ibanman555/Kurzweil-PC2-keyboardscanner/README.md

Kurzweil PC2

# Kurzweil PC2 76-Key MIDI Controller

This repository is for a **Kurzweil PC2 76-key keybed converted into a standalone MIDI controller using one Arduino Mega 2560 and a custom shield**.

The hardware and firmware are specifically for the PC2 keybed, its original pitch/mod wheel assembly, the two illuminated switches directly above the wheels (SW4 = Octave Down, SW5 = Octave Up), and a 1/4-inch sustain-pedal input.

## Current verified status

The assembled single-Mega PC2 has physically verified:

- all 76 keys on the Bass and Treble ribbons, including variable MIDI velocity
- pitch wheel
- mod wheel
- octave down / normal / octave up
- the two original button LEDs following the correct octave state
- the disconnected-J11 startup protection for the pitch/mod analog inputs
- the sustain firmware/input path

PC2 PRESSR/aftertouch is routed to A3 for future use, but aftertouch MIDI output is intentionally not enabled yet.

## Downloading and opening the Arduino sketch

GitHub's downloaded ZIP adds a suffix to the repository folder name, so the firmware is intentionally kept in its own valid Arduino sketch folder:

```text
keyboardscanner/
    keyboardscanner.ino
    globals.h
    scanner.cpp
    states.cpp
    midi.cpp
    potentiometers.cpp
    velocity.h
    extensions.h
    models/kurzweil_pc2/...
```

After downloading and extracting the ZIP, open:

```text
keyboardscanner/keyboardscanner.ino
```

**Keep the entire `keyboardscanner` folder together. Do not move only the `.ino` file.**

In Arduino IDE select **Arduino Mega or Mega 2560**, install the **DIO2** library, then compile and upload.

## Legacy dual-Mega prototype MIDI connection

This project's prototype used 2 separate Arduino Mega 2560s to allow both PC2 keybed ribbon connectors to be attached to the digital pins without modification. The successful dual-Mega prototype used the Mega's normal USB serial connection as a COM port and Bome as the serial-to-MIDI bridge:

- Serial speed: **31250 baud**
- Format: **8N1**
- Arduino Serial Monitor: **closed**
- Bome: configure the Mega COM port as a serial MIDI input

The stock Mega 2560 USB connection is a serial/COM device, not a native USB-MIDI device. The firmware sends standard MIDI bytes through `Serial` at 31250 baud, exactly as used in the prototype.

### Optional native USB-MIDI with HIDUINO

After the PC2 sketch has been compiled and uploaded to the Mega 2560, the board can alternatively be configured as a **class-compliant USB-MIDI device** using [HIDUINO](https://github.com/ddiakopoulos/hiduino).

HIDUINO does not replace the PC2 sketch on the main ATmega2560. Instead, it replaces the normal `usbserial` firmware on the Mega's separate USB-interface AVR. HIDUINO officially supports the Mega 2560 when that USB-interface chip is an **ATmega16U2** (Mega 2560 R3) or **ATmega8U2** (older revisions). It does **not** work on Mega-compatible boards that use a fixed USB-to-serial chip such as CH340, FTDI, or CP2102.

The current PC2 sketch is already compatible with HIDUINO as written. `keyboardscanner.ino` starts UART0 with `Serial.begin(31250)`, and HIDUINO's `arduino_midi` firmware also initializes its serial side at **31250 baud**. The PC2 firmware's normal MIDI path sends the MIDI status and data bytes with `Serial.write()`; HIDUINO receives those raw MIDI bytes and presents them to the computer as a class-compliant USB-MIDI device. No Bome serial-to-MIDI bridge is required once HIDUINO is installed.

The source file `keyboardscanner/midi.cpp` does contain `Serial.print()` / `Serial.println()` statements for diagnostics, but they are inside the compile-time-only `DEBUG_VELOCITY_TIMES` and `DEBUG_MIDI_MESSAGE` sections. Those debug options are **not enabled in the current PC2 build**, so the debug text is not compiled into the running firmware and is safe to leave in the source when HIDUINO is used. **Do not enable either debug option while HIDUINO is active**, because ASCII debug text would then be inserted into the same serial byte stream HIDUINO interprets as MIDI.

#### Included ATmega16U2 firmware and recommended programmer

For Mega 2560 boards that use an **ATmega16U2** as the USB interface, this repository now includes the exact USB-interface firmware used for this PC2 project:

- **[ATmega_16u2_PC2.hex](firmware/atmega16u2/ATmega_16u2_PC2.hex)** — custom HIDUINO build with the USB product name changed to **Kurzweil PC2**. With the PC2 sketch running on the main ATmega2560, the board appears to the computer as a class-compliant USB-MIDI device named **Kurzweil PC2**.
- **[usbserial_mega_16u2.hex](firmware/atmega16u2/usbserial_mega_16u2.hex)** — restore firmware for returning the Mega 2560 ATmega16U2 to its normal USB serial/COM-port behavior.
- **[ATmega16U2 flashing guide](firmware/atmega16u2/README.md)** — programming target, connection, recovery, and ISP instructions.

These two HEX files are specifically for the **ATmega16U2 USB-interface MCU**, not the main ATmega2560 that runs the PC2 sketch. Do not flash them to the main ATmega2560, and do not use these 16U2 images on an 8U2 or on Mega-compatible boards with CH340, FTDI, CP2102, or similar USB chips.

For easy installation and recovery, this project recommends the **Olimex AVR-ISP-MK2**, available from Mouser as **Mouser # 909-AVR-ISP-MK2**: https://www.mouser.com/ProductDetail/Olimex-Ltd/AVR-ISP-MK2

When programming these files, connect the AVR-ISP-MK2 to the **ATmega16U2's 2x3 ICSP header near the Mega's USB connector**, not the separate ICSP header for the main ATmega2560.

**Important development limitation:** once HIDUINO is loaded on the 8U2/16U2, the Mega no longer provides its normal USB serial/COM interface, so the Arduino IDE cannot upload changes to the PC2 sketch through the normal USB cable. To edit and re-upload the PC2 sketch, either temporarily restore the Mega's `usbserial` firmware, upload the revised sketch, and then re-flash HIDUINO, or leave HIDUINO installed and program the main ATmega2560 through its ISP header using **Upload Using Programmer**. HIDUINO's own documentation specifically notes that sketches cannot be bootloaded over USB while HIDUINO is installed on the USB-controller AVR.

#### Changing the USB MIDI device name

The included [`firmware/atmega16u2/ATmega_16u2_PC2.hex`](firmware/atmega16u2/ATmega_16u2_PC2.hex) is already compiled with the USB product name **Kurzweil PC2**. Rebuilding HIDUINO from source is only necessary if you want to change that USB device name again.

In HIDUINO, edit:

`src/arduino_midi/Descriptors.c`

The current product-name descriptor is:

```c
const USB_Descriptor_String_t PROGMEM ProductString =
    USB_STRING_DESCRIPTOR(L"arduino_midi");
```

Change the text inside the wide-character string to the desired name, for example:

```c
const USB_Descriptor_String_t PROGMEM ProductString =
    USB_STRING_DESCRIPTOR(L"Kurzweil PC2");
```

The manufacturer string can also be changed in the same file if desired:

```c
const USB_Descriptor_String_t PROGMEM ManufacturerString =
    USB_STRING_DESCRIPTOR(L"hiduino project");
```

After changing `ProductString` (and optionally `ManufacturerString`), rebuild the HIDUINO `arduino_midi` firmware and flash the newly compiled HEX file to the Mega's 8U2/16U2 USB-interface chip. Renaming the HEX file itself does **not** change the USB device name; the descriptor must be changed before compilation.

HIDUINO source: [ddiakopoulos/hiduino](https://github.com/ddiakopoulos/hiduino)  
Device-name source file: [src/arduino_midi/Descriptors.c](https://github.com/ddiakopoulos/hiduino/blob/master/src/arduino_midi/Descriptors.c)

## Final Arduino Mega 2560 pinout

| Function | Mega pin(s) |
|---|---|
| J8 Bass ribbon | D22-D37 |
| J9 Treble pins 1-12 | D38-D49 |
| J9 Treble pins 13-20 | D2-D9 |
| SW4 / Octave Down button | D11 |
| SW5 / Octave Up button | D10 |
| SW4 / Octave Down LED | D12 |
| SW5 / Octave Up LED | D13 |
| Pitch | A0 |
| Mod | A1 |
| Sustain | A2 |
| Aftertouch / PRESSR | A3 |

### Reserved interfaces

- D14-D15: Serial3
- D16-D17: Serial2
- D18-D19: Serial1
- D20-D21: I2C
- D50-D53: SPI
- A4-A15: available

D0/D1 are used by `Serial`/UART0 and are shared with the Mega's USB-to-serial interface. Leave them unconnected when using the USB/COM-to-Bome MIDI path.

## Keybed scanner settings

- 76 keys
- First MIDI note: 28
- Last MIDI note: 103
- Bass section: notes 28-59
- Treble section: notes 60-103
- Velocity timing range: 1800-80000 us
- Velocity curve: linear 0-127 (**current working baseline; intentionally easy to retune later**)
- Matrix settling delay: 3 us

The final assembled keybed uses different contact order on its two ribbon sections:

- **Bass:** BR closes first, MK closes second, so `pins.h` stores **MK then BR**.
- **Treble:** MK closes first, BR closes second, so `pins.h` stores **BR then MK**.

`states.cpp` requires **SECOND contact first, FIRST contact second** in `pins.h`. This exact ordering is required for velocity timing; reversing the treble pair makes its timing interval collapse and causes full-velocity notes. The assembled keyboard has now verified the order above.

## Velocity calibration and future curve tuning

The currently working velocity baseline is:

- `MIN_TIME_US = 1800`
- `MAX_TIME_US = 80000`
- `velocity.h` = a 128-entry linear table from 0 to 127

The contact ordering in `pins.h` is now hardware-verified and **should not be changed when adjusting playing feel**. Future velocity tuning should be done by changing the timing limits in `model.h`, the response table in `velocity.h`, or both.

`midi.cpp` first converts the measured contact time into a 0-127 linear velocity index, then passes that index through `VELOCITY_CURVE`. This makes `velocity.h` the intended place to create a softer, harder, or otherwise shaped response without changing the key matrix.

The automated test permits a non-linear velocity table as long as it has 128 values, stays within MIDI 0-127, begins at 0, ends at 127, and never decreases.

For timing diagnostics, `DEBUG_VELOCITY_TIMES` can be enabled temporarily, but **not while HIDUINO is active**, because debug text would be inserted into the MIDI serial stream. Restore the normal USB-serial firmware or use another debug path before enabling serial velocity diagnostics.

## Controls

### Pitch

PC2 6-pin wheel connector pin 2 -> A0.

The pitch input is mapped as 14-bit MIDI Pitch Bend. The current production calibration uses a **96-count ADC center dead zone** around raw center 512. This value was verified on the prototype with the original PC2 pitch potentiometer, which has some mechanical return variation. Any reading inside the dead zone is forced to exact MIDI pitch-bend center **8192**.

### Mod

PC2 6-pin wheel connector pin 3 -> A1.

The measured PC2 mod-wheel output is approximately 0.008-3.6 V. The successful prototype used ADC raw **2-736**, which the firmware maps to the full MIDI CC1 range 0-127.

### Safe startup with J11 disconnected

A0 and A1 are analog inputs. On an Arduino Mega 2560, an unconnected analog input floats and can otherwise look like constant pitch-wheel or mod-wheel movement.

The production firmware now performs a startup connection check on the pitch and mod inputs. It briefly enables the AVR's internal pull-up resistor on each analog input before MIDI output begins:

- a real PC2 control holds the input below full-scale and is enabled;
- an open/floating input is pulled close to ADC 1023 and is left disabled;
- disconnected J11 therefore does **not** generate a stream of false Pitch Bend or CC1 messages.

Connect J11 before powering or resetting the Mega. If J11 is plugged in after startup, reset the Mega so the connection check runs again. For the most reliable pitch detection, leave the pitch wheel released/centered during power-up.

### Sustain

J12 uses a Neutrik **NMJ4HCD2** switched mono jack. In the current manufacturing package:

- physical **T (tip)** contact -> A2
- physical **S (sleeve)** contact -> GND
- **TN** and **SN** switching contacts -> not connected

The J12 footprint is the official NMJ4HCD2 12.70 mm x 16.23 mm four-pin geometry with 1.40 mm drills, rotated 180 degrees as a complete footprint so the jack remains mechanically clear of J10 while its physical contact identities stay correct.

The firmware learns pedal polarity at startup. **Plug the pedal in and leave it released while powering on or resetting the Mega.**

### SW4 / SW5 octave buttons and LEDs

The two original illuminated buttons located **just above the pitch and mod wheels** are used for octave shift. The verified physical mapping is:

- **SW4 = Octave Down** -> D11
- **SW5 = Octave Up** -> D10
- **SW4 LED = Octave Down indicator** -> D12 through a series resistor
- **SW5 LED = Octave Up indicator** -> D13 through a series resistor

At normal octave both LEDs are off. Selecting octave down lights SW4; selecting octave up lights SW5. The code remembers the octave used for each Note On so the matching Note Off is sent to the same transposed note even if the octave is changed while a key is held.

330 ohm or 470 ohm is recommended for each LED series resistor. 1 kohm works but is visibly dimmer.

## Automated verification

The repository includes:

- a PC2-specific static mapping check in `keyboardscanner/tests/verify_pc2.py`
- a GitHub Actions build that compiles the actual sketch for **Arduino Mega 2560** with DIO2

These checks protect the 76-key mapping, contact order, shield pin assignments, velocity-table size, and basic compile compatibility.

## Hardware and personal PCB manufacturing

The custom Mega 2560 shield can be fabricated from the project's KiCad-exported Gerber and drill package. The manufacturing ZIP is included in this repository for personal PCB fabrication. This shield allows all integrated keybed, wheel & button/LED connectors to terminate to the 2560 without modification.

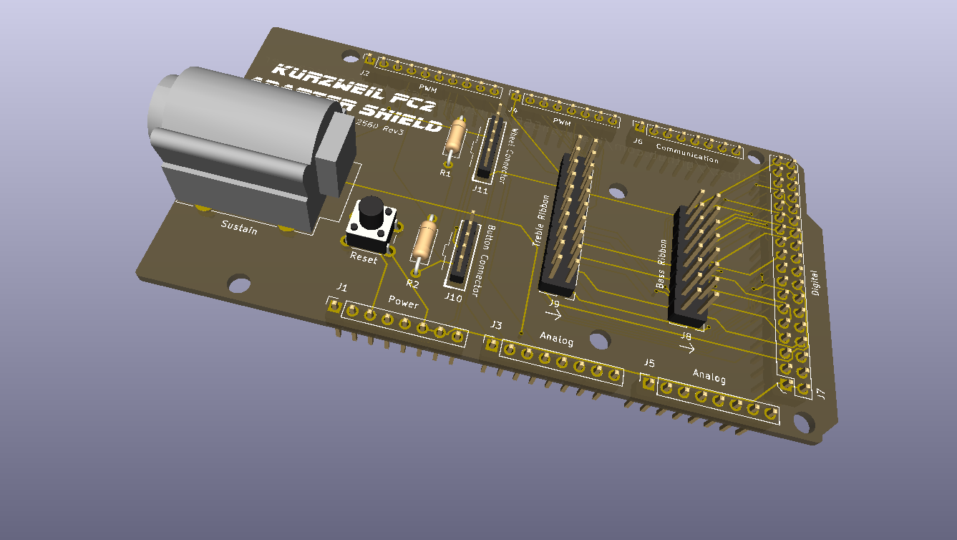
[picture p1: hardware/PC2 Shield Graphic_2.png]
PC2 Shield


**[Download the PC2 Shield PCB manufacturing Gerber package](hardware/PC2%20Board.zip)**

### Bill of materials

- **[View the PC2 Shield BOM on GitHub](hardware/PC2_Shield_BOM.md)**
- **[Open the full PC2 Shield BOM CSV](hardware/PC2_Shield_BOM.csv)**

See the hardware guide for the manufacturing file list, ordering guidance, connector pinouts, BOM, and assembly precautions. The included manufacturing ZIP contains the current NMJ4HCD2 J12 footprint.

See:

- [hardware/README.md](hardware/README.md)
- [keyboardscanner/models/kurzweil_pc2/README.md](keyboardscanner/models/kurzweil_pc2/README.md)

## License / attribution

The key-scanning state-machine foundation was originally released under GPLv3 by Daniel Moura. The PC2 matrix mapping, shield pinout, wheel calibration, octave controls, sustain implementation, and single-Mega integration in this repository are specific to this Kurzweil PC2 project.
