ibanman555/Kurzweil-PC2-keyboardscanner/hardware/README.md

# PC2 Mega 2560 shield

This hardware is a custom Arduino Mega 2560 shield designed for the Kurzweil PC2 76-key MIDI-controller conversion. It connects both keybed ribbons, the original pitch/mod/pressure board, the two illuminated octave buttons, and a 1/4-inch TS sustain jack to a single Mega.

## Personal PCB manufacturing

**[Download the PC2 Shield PCB manufacturing Gerber package](PC2%20Board.zip)**

### PCB layout

Kurzweil PC2 Arduino Mega 2560 adapter shield PCB layout

*PC2 adapter shield PCB layout and component placement.*

## Bill of materials

- **[View the GitHub-formatted PC2 Shield BOM](PC2_Shield_BOM.md)** — concise, human-readable parts table with datasheet links.
- **[Open the full PC2 Shield BOM CSV](PC2_Shield_BOM.csv)** — CSV-format BOM for viewing or importing into a spreadsheet.
- **[Download the original Mouser XLS BOM](282323296.xls)** — original spreadsheet source.

The Markdown and CSV BOMs are for **one PC2 Shield**. The shield is designed for personal PCB fabrication. The original KiCad-exported manufacturing package supplied for this project is named **PC2 Board.zip** and contains these fabrication files:

| File | Purpose |
|---|---|
| `PC2 Shield-F_Cu.gbr` | Front copper |
| `PC2 Shield-B_Cu.gbr` | Back copper |
| `PC2 Shield-F_Mask.gbr` | Front solder mask |
| `PC2 Shield-B_Mask.gbr` | Back solder mask |
| `PC2 Shield-F_Silkscreen.gbr` | Front silkscreen |
| `PC2 Shield-B_Silkscreen.gbr` | Back silkscreen |
| `PC2 Shield-Edge_Cuts.gbr` | Board outline |
| `PC2 Shield-PTH.drl` | Plated drill holes |
| `PC2 Shield-NPTH.drl` | Non-plated drill holes |
| `PC2 Shield-job.gbrjob` | Gerber job metadata |

**Manufacturing instructions:** Upload the ZIP of Gerber and drill files to a PCB fabrication service. Review its Gerber preview for the board outline, holes, copper, silkscreen, and orientation before ordering. The package is for a **bare PCB**, not an assembled board: connectors, resistors, the sustain jack, and the Arduino Mega must be supplied and assembled separately.

**Status:** The current shield design uses the verified keybed, velocity, pitch, mod, octave-button and octave-LED mappings. SW4 is Octave Down and SW5 is Octave Up. J12 uses the Neutrik NMJ4HCD2 footprint with T -> A2 and S -> GND.

The final shield combines the complete Kurzweil PC2 keybed and controls onto one Arduino Mega 2560.

## Shield schematic

Kurzweil PC2 Arduino Mega 2560 adapter shield schematic

*Complete shield schematic showing the Mega 2560 headers, J8/J9 keybed ribbons, J10 buttons and LEDs, J11 wheel connector, and J12 sustain input.*

## J8 - Bass keybed ribbon

Pins 1-16 connect sequentially to Mega D22-D37.

## J9 - Treble keybed ribbon

Pins 1-12 connect to D38-D49. Pins 13-20 connect to D2-D9.

The physical treble contact order is **MK first, BR second**. The firmware intentionally stores each treble pair as **BR then MK** because `states.cpp` expects the second-closing contact first. This ordering has been verified on the assembled keyboard and is required for variable treble velocity.

## J10 - SW4 / SW5 octave buttons and LEDs

J10 connects the two original illuminated buttons located **just above the PC2 pitch and mod wheels**. The verified physical functions are:

- **SW4 = Octave Down**
- **SW5 = Octave Up**

The working J10-to-Mega pinout is:

| J10 pin | PC2 control | Function | Mega pin |
|---:|---|---|---:|
| 1 | SW4 LED | Octave-down LED | D12 through series resistor |
| 2 | SW5 LED | Octave-up LED | D13 through series resistor |
| 3 | SW5 | Octave-up button | D10 |
| 4 | SW4 | Octave-down button | D11 |
| 5 | Common | Button/LED common | GND |

Use one current-limiting resistor per LED. 330 ohm or 470 ohm is recommended; 1 kohm works but is visibly dimmer. At normal octave both LEDs are off; selecting octave down lights SW4 through D12, and selecting octave up lights SW5 through D13.

## J11 - Wheels / pressure

| J11 pin | Function | Mega pin |
|---:|---|---:|
| 1 | +5 V reference | +5V |
| 2 | Pitch wheel | A0 |
| 3 | Mod wheel | A1 |
| 4 | Aftertouch / PRESSR | A3 |
| 5 | Analog ground | GND |
| 6 | NC | NC |

Pitch and mod are enabled. A3 is routed for PC2 channel aftertouch/pressure, but aftertouch MIDI output is intentionally not enabled yet because the original pressure strip is still being mechanically evaluated.

**J11 startup behavior:** A0 and A1 are analog inputs and would normally float when J11 is unplugged. The firmware performs a startup connection check using the Mega's internal pull-ups and disables any pitch/mod channel that still looks open, preventing false Pitch Bend or CC1 messages from an unconnected shield. Connect J11 before powering or resetting the Mega. If J11 is connected after startup, reset the Mega so the control inputs are detected again. Leave the pitch wheel released/centered during startup.

## J12 - Sustain pedal

J12 uses the **Neutrik NMJ4HCD2** (Mouser **550-12202**), a switched mono 1/4-inch horizontal PCB jack.

### J12 footprint

The current manufacturing files use the NMJ4HCD2's official four-pin geometry:

| Physical jack contact | PCB net |
|---|---|
| T (tip) | A2 |
| S (sleeve) | GND |
| TN (tip normal) | NC |
| SN (sleeve normal) | NC |

Verified footprint dimensions in the current Gerbers:

- T-to-S spacing: **12.70 mm**
- T-to-TN / S-to-SN spacing: **16.23 mm**
- plated drill diameter: **1.40 mm**
- the complete NMJ4HCD2 footprint is rotated **180 degrees** from the library's default orientation so the jack fits the shield without colliding with J10; the pad identities rotate with the component, so T and S remain the actual plug contacts

Current manufacturing archive:

- file: `hardware/PC2 Board.zip`
- generated by KiCad 10.0.6
- SHA-256: `c6d53a8a959ad8adc007ed96dc398ed8888c3c8c9d75b9f405eb97800d9d8718`

Firmware learns sustain-pedal polarity at power-up. Plug the pedal in and leave it released while powering on or resetting the Mega.

## Reserved interfaces

- D14-D15: Serial3
- D16-D17: Serial2
- D18-D19: Serial1
- D20-D21: I2C
- D50-D53: SPI
- A4-A15: unused analog pins

D0/D1 remain the primary serial/MIDI interface used by the sketch.
