ibanman555/Kurzweil-PC2-keyboardscanner/hardware/PC2 Shield Graphic.png

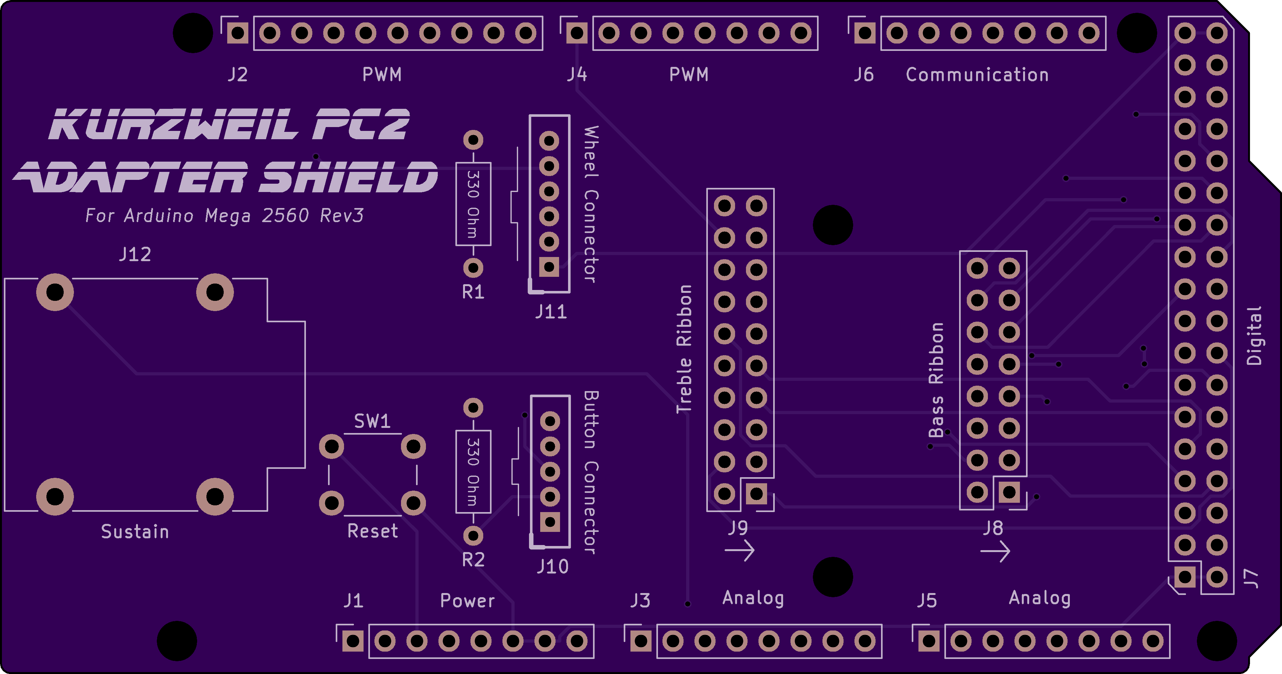
hardware/PC2 Shield Graphic.png
