ibanman555/Kurzweil-PC2-keyboardscanner/hardware/PC2_Shield_BOM.md

# PC2 Shield Bill of Materials

> **J12 sustain jack:** Mouser **550-12202 / Neutrik NMJ4HCD2**. Use the included `PC2 Board.zip` manufacturing package.

GitHub-viewable BOM for **one PC2 Shield**, generated from the Mouser spreadsheet.

| Mouser Part Number | Mfr Part Number | Manufacturer Name | Description | Qty / Shield | Datasheet URL |
| --- | --- | --- | --- | --- | --- |
| 200-TSW10807FS | TSW-108-07-F-S | Samtec | Headers & Wire Housings Headers & Wire Housings Classic PCB Header Strips | 5 |  |
| 200-TSW11007TS | TSW-110-07-T-S | Samtec | Headers & Wire Housings Headers & Wire Housings Classic PCB Header Strips | 1 |  |
| 200-TSW11807GD | TSW-118-07-G-D | Samtec | Headers & Wire Housings Headers & Wire Housings Classic PCB Header Strips | 1 |  |
| 200-TSW10807TD | TSW-108-07-T-D | Samtec | Headers & Wire Housings Headers & Wire Housings Classic PCB Header Strips | 1 | [Datasheet](https://suddendocs.samtec.com/prints/tsw-xxx-xx-xxx-x-xx-xxx-mkt.pdf) |
| 200-TSW11007TD | TSW-110-07-T-D | Samtec | Headers & Wire Housings Headers & Wire Housings 2.54MM CLASSIC PCB HDR STRIP | 1 | [Datasheet](https://suddendocs.samtec.com/prints/tsw-xxx-xx-xxx-x-xx-xxx-mkt.pdf) |
| 855-M22-2510505 | M22-2510505 | Harwin | Headers & Wire Housings Headers & Wire Housings M22 5 PIN SIL HOUSING | 1 | [Datasheet](https://www.mouser.com/datasheet/3/71/1/M22_251.pdf) |
| 855-M22-2510605 | M22-2510605 | Harwin | Headers & Wire Housings Headers & Wire Housings M22 6 PIN SIL HOUSING | 1 | [Datasheet](https://www.mouser.com/datasheet/3/71/1/M22_251.pdf) |
| 550-12202 | NMJ4HCD2 | Neutrik | Phone Connectors Phone Connectors 2C MONO 2-SPST NC | 1 | [Datasheet](https://4donline.ihs.com/images/VipMasterIC/IC/NUAG/NUAG-S-A0000255784/NUAG-S-A0000255840-1.pdf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) |
| 594-MRS25000C3300FCT | MRS25000C3300FCT00 | Vishay | Metal Film Resistors - Through Hole Metal Film Resistors - Through Hole .6watt 330ohms 1% | 2 | [Datasheet](https://www.vishay.com/doc?28724) |
| 653-B3F-1050 | B3F-1050 | Aratas | Tactile Switches Tactile Switches 6X6 Proj 7.3mm Btn Force 100g w/o Grd | 1 | [Datasheet](https://www.mouser.com/datasheet/3/39/1/en_b3f.pdf) |
