ibanman555/Kurzweil-PC2-keyboardscanner/keyboardscanner/models/kurzweil_pc2/pins.h

// Kurzweil PC2 76-key matrix for the final single-Mega shield.
// states.cpp expects each key as SECOND contact first, FIRST contact second.
// PINS(output_pin, input_pin): BR/MK are scanned outputs, T lines are INPUT_PULLUP.

// BASS - 32 keys. BR closes FIRST, MK closes SECOND.
PINS(BASS_MK0, BASS_T0)
PINS(BASS_BR0, BASS_T0)
PINS(BASS_MK0, BASS_T1)
PINS(BASS_BR0, BASS_T1)
PINS(BASS_MK0, BASS_T2)
PINS(BASS_BR0, BASS_T2)
PINS(BASS_MK0, BASS_T3)
PINS(BASS_BR0, BASS_T3)
PINS(BASS_MK0, BASS_T4)
PINS(BASS_BR0, BASS_T4)
PINS(BASS_MK0, BASS_T5)
PINS(BASS_BR0, BASS_T5)
PINS(BASS_MK0, BASS_T6)
PINS(BASS_BR0, BASS_T6)
PINS(BASS_MK0, BASS_T7)
PINS(BASS_BR0, BASS_T7)

PINS(BASS_MK1, BASS_T0)
PINS(BASS_BR1, BASS_T0)
PINS(BASS_MK1, BASS_T1)
PINS(BASS_BR1, BASS_T1)
PINS(BASS_MK1, BASS_T2)
PINS(BASS_BR1, BASS_T2)
PINS(BASS_MK1, BASS_T3)
PINS(BASS_BR1, BASS_T3)
PINS(BASS_MK1, BASS_T4)
PINS(BASS_BR1, BASS_T4)
PINS(BASS_MK1, BASS_T5)
PINS(BASS_BR1, BASS_T5)
PINS(BASS_MK1, BASS_T6)
PINS(BASS_BR1, BASS_T6)
PINS(BASS_MK1, BASS_T7)
PINS(BASS_BR1, BASS_T7)

PINS(BASS_MK2, BASS_T0)
PINS(BASS_BR2, BASS_T0)
PINS(BASS_MK2, BASS_T1)
PINS(BASS_BR2, BASS_T1)
PINS(BASS_MK2, BASS_T2)
PINS(BASS_BR2, BASS_T2)
PINS(BASS_MK2, BASS_T3)
PINS(BASS_BR2, BASS_T3)
PINS(BASS_MK2, BASS_T4)
PINS(BASS_BR2, BASS_T4)
PINS(BASS_MK2, BASS_T5)
PINS(BASS_BR2, BASS_T5)
PINS(BASS_MK2, BASS_T6)
PINS(BASS_BR2, BASS_T6)
PINS(BASS_MK2, BASS_T7)
PINS(BASS_BR2, BASS_T7)

PINS(BASS_MK3, BASS_T0)
PINS(BASS_BR3, BASS_T0)
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

// Final four treble keys use T0-T3 only.
PINS(TREBLE_MK10, TREBLE_T0)
PINS(TREBLE_BR10, TREBLE_T0)
PINS(TREBLE_MK10, TREBLE_T1)
PINS(TREBLE_BR10, TREBLE_T1)
PINS(TREBLE_MK10, TREBLE_T2)
PINS(TREBLE_BR10, TREBLE_T2)
PINS(TREBLE_MK10, TREBLE_T3)
PINS(TREBLE_BR10, TREBLE_T3)
