ibanman555/Kurzweil-PC2-keyboardscanner/keyboardscanner/midi.cpp

/*
Moura's Keyboard Scanner: turn you broken (or unused) keyboard in a MIDI controller
Copyright (C) 2017 Daniel Moura <oxesoft@gmail.com>

This code is originally hosted at https://github.com/oxesoft/keyboardscanner
*/

// Enables debug mode to check MIN_TIME_US and MAX_TIME_US values
// #define DEBUG_VELOCITY_TIMES

// Uncomment the next line to get text MIDI messages at output
// #define DEBUG_MIDI_MESSAGE

#define DEFINE_BLACK_KEYS_MAP
#include "globals.h"
#include "velocity.h"
#include <assert.h>

#define SIZEOF_VELOCITY_CURVE 128
static_assert(sizeof(VELOCITY_CURVE) == SIZEOF_VELOCITY_CURVE, "Invalid velocity curve");

extern int8_t octave_shift;
static int8_t note_octave[KEYS_NUMBER] = {0};

bool isBlack(byte note)
{
    switch (note % 12)
    {
        case 1:
        case 3:
        case 6:
        case 8:
        case 10:
            return true;
        default:
            return false;
    }
}

void sendKeyEvent(byte status_byte, byte key_index, unsigned long time)
{
    // Remember the octave used for Note On so Note Off always targets the same note,
    // even if the player changes octave while a key is held.
    int8_t thisOctave;
    if (status_byte == 0x90)
    {
        note_octave[key_index] = octave_shift;
        thisOctave = octave_shift;
    }
    else
    {
        thisOctave = note_octave[key_index];
    }

    int note = FIRST_KEY + key_index + (thisOctave * 12);
    if (note < 0) note = 0;
    if (note > 127) note = 127;
    byte key = (byte)note;

#ifdef BLACK_KEYS_VELOCITY_MULTIPLIER
    if (isBlack(key))
    {
        time = (time * BLACK_KEYS_VELOCITY_MULTIPLIER) >> 7;
    }
#endif

    unsigned long t = constrain(time, MIN_TIME_US, MAX_TIME_US);
    t -= MIN_TIME_US;

    unsigned long linear_velocity = 127 - ((t * 127) / (MAX_TIME_US - MIN_TIME_US));
    byte vel = VELOCITY_CURVE[linear_velocity];

    // MIDI Note On with velocity 0 is interpreted as Note Off.
    if (status_byte == 0x90 && vel == 0)
    {
        vel = 1;
    }

#ifdef DEBUG_VELOCITY_TIMES
    Serial.print("KEY_");
    Serial.print(status_byte == 0x90 ? "ON " : "OFF");
    Serial.print(":");
    Serial.print(key_index);
    Serial.print(" TIME:");
    Serial.print(time);
    Serial.print(" RAW:");
    Serial.print(linear_velocity);
    Serial.print(" VEL:");
    Serial.println(vel);
#else
    sendMidiEvent(status_byte, key, vel);
#endif
}

void sendSustainPedalEvent(boolean pressed)
{
    sendMidiEvent(0xB0, 0x40, pressed ? 0x7F : 0x00);
}

void sendMidiEvent(byte status_byte, byte data1, byte data2)
{
#ifdef DEBUG_MIDI_MESSAGE
    Serial.print(status_byte, 16);
    Serial.print(" ");
    Serial.print(data1, 16);
    Serial.print(" ");
    Serial.println(data2, 16);
#else
    Serial.write(status_byte);
    Serial.write(data1);
    Serial.write(data2);
#endif
}
