ibanman555/Kurzweil-PC2-keyboardscanner/(commit log)

2026-04-23 Update Link Assembly Video and axiom parameters
2026-08-19 Clarify cable setup instructions in README
    Updated wording for clarity regarding cable setup.
2026-10-07 Clarify SW4/SW5 octave controls above pitch and mod wheels
2026-10-07 Label SW4/SW5 octave controls in model pin definitions
2026-10-07 Fix treble contact order to match verified prototype
    [pins.h]
2026-10-07 Restore prototype-verified linear velocity curve
2026-10-07 Match mod-wheel calibration to working prototype
2026-10-07 Document prototype-verified calibration baseline
2026-10-07 Strengthen PC2 control and calibration verification
2026-10-07 Document PC2 shield Gerber fabrication and personal manufacturing
2026-10-07 Link personal PCB manufacturing instructions from main README
2026-10-08 Add files via upload
    Attached .zip file for 2560 shield manufacturing.
2026-10-08 Add PC2 photo header and Gerber download link
2026-10-08 Add direct PCB Gerber download in hardware guide
2026-10-08 Add GitHub-viewable PC2 shield BOM
2026-10-08 Add PC2 shield BOM CSV
    [PC2_Shield_BOM.csv]
2026-10-08 Add PC2 shield BOM links
2026-10-08 Document PC2 shield BOM files
2026-10-08 Link original Mouser BOM spreadsheet
2026-10-08 Normalize PC2 Shield BOM quantities for one board
2026-10-08 Normalize PC2 Shield CSV quantities for one board
    [PC2_Shield_BOM.csv]
2026-10-08 Clarify BOM quantities are per shield
2026-10-08 Remove unit price and availability from BOM
2026-10-08 Remove unit price and availability from BOM CSV
    [PC2_Shield_BOM.csv]
2026-10-08 Update BOM CSV description
2026-10-08 Update README with PC2 Shield image and download link
    Added image and download link for PC2 Shield PCB.
2026-10-08 Remove unused price columns from PC2 Shield BOM CSV
    [PC2_Shield_BOM.csv]
2026-10-16 Prevent false MIDI from disconnected PC2 analog controls
    Add startup detection for open A0/A1 inputs, restore the tested 96-count pitch deadzone, initialize the mod baseline safely, document J11 startup behavior, and extend verification.
2026-10-16 Correct octave button and LED mapping
    Swap the octave-up/down button and LED assignments to match the final assembled shield, and update verification and documentation.
2026-10-16 Fix octave button LED outputs
    Keep the verified octave button inputs unchanged and swap only the LED output assignments so each physical button lights for its own octave function. Update tests and documentation to match the assembled shield.
2026-10-16 Fix treble velocity timing
    Reverse only the treble contact-pair ordering to match the assembled PC2 keybed so velocity timing is measured between the correct first and second contacts. Update documentation and verification to lock the corrected mapping.
2026-10-16 Finalize verified hardware documentation and velocity tuning workflow
    Record the final working shield mappings, correct J10 connector pin identities, document verified Bass/Treble contact order, and keep the velocity response intentionally tunable without changing the verified matrix.
2026-10-16 Correct J12 sustain jack footprint and manufacturing package
    Replace the manufacturing ZIP with the corrected NMJ4HCD2 footprint orientation and update hardware, model, BOM, and root documentation to reflect the verified sustain-jack geometry.
2026-10-16 Keep J12 docs focused on current PCB design
    Remove obsolete sustain-jack issue history and leave only the current NMJ4HCD2 footprint, routing, and manufacturing information.
2026-10-17 Correct SW4/SW5 octave labels and J10 pinout
    Correct the physical SW4/SW5 names throughout the repository while preserving the verified working octave pin assignments: SW4/down on D11, SW5/up on D10, SW4 LED/down on D12, SW5 LED/up on D13.
2026-10-17 Add PCB layout and schematic images to hardware README
    Add the PC2 shield PCB layout under manufacturing and the full shield schematic before the connector pinout documentation.
2026-10-17 Add detailed PC2 velocity tuning guide
    Add a dedicated guide for calibrating MIN/MAX key timing and shaping the 128-entry velocity curve, with diagnostic instructions, safe tuning workflow, and links from the main and model READMEs.
